wangykev/Splitflap/Kevin Splitflap/[Build18 2027] Team #138 - Parts List.xlsx

Part Name | Quantity | Unit Cost | Total Cost | Link | Who will purchase? (Build18/Ourselves) | Replacement Option Quantity | Replacement Option Unit Cost | Replacement Option Link
1. Module hardware (45 split-flap modules)
M3 hex nut, 304 stainless, 300-pc pack (need 540) | 2 | $6.88 |  | https://www.amazon.com/dp/B0DM1JHK1D | Build18
M3 x 8 mm countersunk flat-head screw, KADRICK, 300-pc pack (need 180) | 1 | $8.99 |  | https://www.amazon.com/dp/B0H1CKZ7PS | Build18
M3 x 30 mm countersunk flat-head screw, KADRICK, 200-pc pack (need 180) | 1 | $7.99 |  | https://www.amazon.com/dp/B0H1CMJY7Q | Build18
M3 x 40 mm countersunk flat-head screw, KADRICK, 170-pc pack (need 190) | 2 | $7.99 |  | https://www.amazon.com/dp/B0H1CTDXTB | Build18
A3144 Hall-effect sensor, 30-pc pack (need 45) | 2 | $6.88 |  | https://www.amazon.com/dp/B0DQ4GV916 | Build18
28BYJ-48 stepper motor, 12 V version (NOT 5 V), 5-wire with JST-XH plug, 6 motors + 6 ULN2003 boards per pack (need 45 + 3 spares). Select the 12 V option | 8 | $14.49 |  | https://www.amazon.com/dp/B0CZNGF43R | Build18 | 24 | $8.49 | https://www.amazon.com/dp/B0GQYKFGS3 (DIYables, 2 sets per pack, 12V option)
Pogo pin, 2.0 mm gold, 9 mm (5.0 mm tube, 1.0 mm tail), 100-pc pack (need 184) | 2 | $12.99 |  | https://www.amazon.com/dp/B07FPKKK9W | Build18
Neodymium magnet, N52, 3 mm dia x 1 mm, 1000-pc pack (need 45) | 1 | $21.59 |  | https://www.amazon.com/dp/B0F4CD3GC1 | Build18
JST-PH 2.0 mm 3-pin pigtail cable, 15 cm, 60 pairs (Hall sensor, need 45). Must be JST-PH 2.0 mm, NOT JST-XH; choose the "2.0mm 3Pin-15cm" option | 1 | $12.79 |  | https://www.amazon.com/dp/B0F6SZWBQR | Build18 | 2 | $8.29 | https://www.amazon.com/dp/B0DF2JQXWN (30 sets JST-PH 3-pin, 15 cm)
35 mm DIN rail, slotted steel, 1 m | 3 | $7.95 |  | https://www.amazon.com/dp/B019Q9E86W | Build18
2. Programming (UPDI flasher)
CH340 USB-to-TTL serial adapter, HiLetgo, 5-pc pack | 1 | $9.79 |  | https://www.amazon.com/dp/B00LZV1G6K | Build18
1N5817 Schottky diode, BOJACK, 125-pc pack | 1 | $5.99 |  | https://www.amazon.com/dp/B07Q5H1SLY | Build18
Dupont F-M jumper wires, 20 cm, 40 pcs (already own) | 1 | $0.00 |  | https://www.amazon.com/dp/B0BRTHR2RL | Ourselves
3. Gateway & RS-485 bus
Waveshare ESP32-S3-RS485-CAN industrial control board (RS485 + CAN) | 1 | $26.87 |  | https://www.amazon.com/dp/B0FNCWZ3D1 | Build18
Resistor kit, 1/4 W (120 ohm bus termination; the 330 ohm LED data resistor is on the power board) (already own) | 1 | $0.00 |  | https://www.sparkfun.com/resistor-kit-1-4w-500-total.html | Ourselves
Cat-6 cable, 10 ft, twisted pair for RS-485 A/B between rows (already own) | 1 | $0.00 |  | https://vetco.net/products/cat-6_ethernet_cable_10_ft | Ourselves
4. Power
Mean Well OWA-200U-12 power brick, 12 V 15 A 180 W, 4-pin DIN output, US cord | 1 | $61.80 |  | https://www.jameco.com/z/OWA-200U-12-MEAN-WELL-12V-15A-180W-Moisture-proof-Power-Adaptor-DIN4_2324383.html | Build18 | 1 | $61.80 | https://www.bravoelectro.com/owa-200u-12.html
Kycon KPJX-4S-S female 4-pin power DIN jack, right angle, PCB mount | 1 | $1.88 |  | https://www.digikey.com/en/products/detail/kycon-inc/KPJX-4S-S/9990088 | Build18
Main power switch: Switch Components RF2-1A-DC-2-RL mini rocker, SPST off-on, 16 A @ 12 V DC, red LED dot (lights when on), 3 x 0.187" quick-connect tabs, snap-in. Panel cutout 19.2 x 13.0 mm, panel 0.75-3.0 mm thick | 1 | $3.43 |  | https://www.digikey.com/en/products/detail/switch-components/RF2-1A-DC-2-RL/11492834 | Build18 | 1 |  | https://www.jameco.com/z/RF1-1A-DC-2-B-2-Switch-Components-Mini-Rocker-2P-SPST-OFF-ON-with-ON-OFF-Print_2847895.html (Switch Components RF1-1A-DC-2-B-2: same 16 A @ 12 V DC, no LED, ON-OFF printed on the rocker; check price on Jameco)
18 AWG red/black power wire, ~15 ft (already own) | 1 | $0.00 |  | https://vetco.net/products/jsc-2440_18_awg_2_conductor_red-black_speaker_wire_-_power_wire_-usa_made | Ourselves
Heat-shrink tubing assortment (already own) | 1 | $0.00 |  |  | Ourselves
5. LED perimeter strip
BTF-LIGHTING WS2815 12 V addressable LED strip, 144 LED/m, IP30, 1 m reel (need 3 m). Select the 144 LED / 3.2 ft option | 3 | $18.89 |  | https://www.amazon.com/dp/B07LG5JG3Z | Ourselves | 1 | $36.98 | https://www.superlightingled.com/dc12v-ws2815-upgraded-ws2812b-1m-144-leds-individually-addressable-digital-led-strip-lights-dual-signal-wires-waterproof-drea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 (SuperLightingLED WS2815 144/m, IP20, one 3 m reel: choose the 3 m option)
1000 uF 25 V electrolytic capacitor: one on the power board (C1, hand-soldered), one at the LED strip input (already own) | 2 | $0.00 |  | https://vetco.net/products/1000uf25vdc_1000uf_25_volt_electrolytic_capacitor | Ourselves
6. Raspberry Pi + voice satellite
Raspberry Pi 5, 4 GB | 1 | $130.00 |  | https://www.adafruit.com/product/5812 | Ourselves
Official Raspberry Pi 27 W USB-C power supply | 1 | $14.04 |  | https://www.adafruit.com/product/5814 | Ourselves
Official Raspberry Pi 5 Active Cooler | 1 | $13.50 |  | https://www.adafruit.com/product/5815 | Ourselves
Seeed reSpeaker XVF3800 USB 4-mic array, Bare Board (USB version, NOT the XIAO version) | 1 | $69.90 |  | https://www.amazon.com/dp/B0FKGFXQQ5 | Ourselves
VEML7700 ambient light sensor, I2C, STEMMA QT | 1 | $4.95 |  | https://www.adafruit.com/product/4162 | Ourselves
Raspberry Pi 5 case (3D-printing our own) | 1 | $0.00 |  | https://www.adafruit.com/product/5816 | Ourselves
microSD card, 32 GB, high endurance (already own) | 1 | $0.00 |  | https://www.pishop.us/product/sandisk-high-endurance-microsdhc-card-32gb-blank/ | Ourselves
Speaker gasket tape, foam (seals the speaker driver's rim and enclosure seams) | 1 | $5.99 |  | https://www.amazon.com/dp/B0C2KHHDXV | Ourselves
Dayton Audio ND65-4 2.5" aluminum-cone full-range speaker driver, 4 ohm, 15 W RMS (for spoken replies; goes in our own enclosure, driven by the ReSpeaker's 5 W amp) | 1 | $23.98 |  | https://www.parts-express.com/Dayton-Audio-ND65-4-2-1-2-Aluminum-Cone-Full-Range-Driver-290-204 | Build18 | 1 | $9.75 | https://octopart.com/tc6fd00-04-peerless+by+tymphany-78639440 (Peerless by Tymphany TC6FD00-04, 2" full-range, 4 ohm, cheaper but less bass)
7. Case (plywood back, laser-cut acrylic front and sides)
3/8" x 2 ft x 4 ft sanded plywood (back panel), Home Depot. Price is an estimate; check the store | 1 | $18.00 |  | https://www.homedepot.com/b/Lumber-Composites-Plywood/2-ft-x-4-ft/Sanded/N-5yc1vZbqm7Z1z1abxgZ1z1tly8 | Build18
1/8" black cast acrylic sheet, 18 x 36 in, eStreet Plastics #2025 (SKU B011251836) (front panel: 880 x 280 mm fits in 914 x 457 mm) | 1 | $21.14 |  | https://estreetplastics.com/product/1-8-x-18-x-36-black-plexiglass-acrylic-sheet-cast-2025/ | Build18 | 1 | $40.92 | https://www.homedepot.com/p/Falken-Design-24-in-x-36-in-x-1-8-in-Thick-Acrylic-Black-Opaque-Sheet-Falken-Design-ACRYLIC-BK-1-8-2436/308669314 (24 x 36 in, same sheet, if 18 x 36 is out of stock)
1/8" black LED cast acrylic sheet, 24 x 36 in (side panels: one-piece 880 mm top and bottom strips, no seam) | 1 | $59.95 |  | https://laseredbythecreek.com/products/1-8-black-led-cast-acrylic-sheets-matte-gloss-finish | Build18 | 2 | $14.95 | Same listing, 12 x 18 in size (top and bottom would each be two strips joined at the centre)
TOTAL BUILD18 COST
TOTAL OUT-OF-POCKET COST (Ourselves)
TOTAL PROJECT PARTS COST
Excludes the PCBs (driver, bus and power boards; separate JLCPCB order) and all shipping. Rows marked Ourselves are parts we already own or are 3D-printing ourselves, listed at $0.
 |  |  |  |  | SPECIAL NOTES & IMPORTANT INFORMATION - All parts will be ordered directly through Build18. Do not purchase parts independently. - Parts will be available for pickup starting on the first day of Build Week. - Reimbursements are extremely limited and require prior approval, except for PCBs. - Include any special ordering instructions, specifications, or requests in your parts list. - Contact your assigned Build18 officer with any questions.
YOU DO NOT NEED TO ORDER YOUR OWN FILAMENTS |  |  | T-Shirt Details for all members (for Demo Day)
TechSpark 3D Print Use | Quantity |  | Team Member Name | Tshirt Size
FALSE
