wangykev/Splitflap/Kevin Splitflap/PCBs/power-board/production/bom.csv

Designator | Footprint | Quantity | Value | LCSC Part #
C1 | CP_Radial_D10.0mm_P5.00mm | 1 | 1000uF 25V
C2 | 0805 | 1 | 10uF 25V | C15850
C3 | 0603 | 1 | 100nF | C14663
C4 | 0603 | 1 | 470nF | C1623
C5 | 0805 | 1 | 10uF | C15850
D1 | D_SMC | 1 | SMCJ15A | C310016
D2 | 0603 | 1 | ON | C2286
D3 | 0603 | 1 | ROW1 | C2286
D4 | 0603 | 1 | ROW2 | C2286
D5 | 0603 | 1 | ROW3 | C2286
D6 | 0603 | 1 | GW | C2286
F1, F2, F3 | 2920 | 3 | 7A | C22363536
F4 | 2920 | 1 | 3A | C39831901
H1, H2, H3, H4 | MountingHole_3.2mm_M3 | 4 | M3
J1 | Kycon_KPJX-4S-S | 1 | KPJX-4S-S
J10 | SolderWire-1.5sqmm_1x02_P7.8mm_D1.7mm_OD3.9mm | 1 | ROCKER SWITCH
J2 | SolderWire-1sqmm_1x04_P5.4mm_D1.4mm_OD2.7mm | 1 | ROW 1 (12V B A GND)
J3 | SolderWire-1sqmm_1x04_P5.4mm_D1.4mm_OD2.7mm | 1 | ROW 2 (12V B A GND)
J4 | SolderWire-1sqmm_1x04_P5.4mm_D1.4mm_OD2.7mm | 1 | ROW 3 (12V B A GND)
J5 | SolderWire-1sqmm_1x02_P5.4mm_D1.4mm_OD2.7mm | 1 | GATEWAY PWR (12V GND)
J6 | SolderWire-0.5sqmm_1x02_P4.6mm_D0.9mm_OD2.1mm | 1 | GATEWAY RS485 (A B)
J7 | SolderWire-0.5sqmm_1x02_P4.6mm_D0.9mm_OD2.1mm | 1 | GATEWAY IO
J8 | SolderWire-1sqmm_1x04_P5.4mm_D1.4mm_OD2.7mm | 1 | LED START (12V DIN BIN GND)
J9 | SolderWire-1sqmm_1x02_P5.4mm_D1.4mm_OD2.7mm | 1 | LED END (12V GND)
JP1 | SolderJumper-2_P1.3mm_Open_RoundedPad1.0x1.5mm | 1 | TERM
NT1, NT2 | CutLink_Holes_P6mm | 2 | CUT IF REVERSED
R1, R2, R3, R4, R5 | 0603 | 5 | 4.7k | C23162
R7 | 0603 | 1 | 120 | C22787
R8 | 0603 | 1 | 100k | C25803
R9 | 0603 | 1 | 330 | C23138
U1 | SOT-23-5 | 1 | 74AHCT1G125 | C7484
U2 | SOT-89-3 | 1 | 78L05 | C71136
