wangykev/Splitflap/Kevin Splitflap/PCBs/Driverv5/production/bom.csv

Designator | Footprint | Quantity | Value | LCSC Part #
C1 | CP_Elec_6.3x5.4 | 1 | 100u | C4747964
C10, C11, C7 | 0603 | 3 | 100nF | C14663
C2, C3, C6, C8 | 0603 | 4 | 470n | C1623
C4 | 0805 | 1 | 10u | C15850
C5, C9 | 0603 | 2 | 10u | C19702
D1 | 0603 | 1 | LED | C2286
D3 | D_SMA | 1 | D_Schottky | C8678
F1 | 1812 | 1 | 750mA/24V | C12557
J3 | JST_XH_B5B-XH-A_1x05_P2.50mm_Vertical | 1 | Stepper Connector | C157991
J4 | JST_PH_B3B-PH-K_1x03_P2.00mm_Vertical | 1 | Hall Effect | C131339
R2 | 0603 | 1 | 470R | C23179
R3, R4 | 0603 | 2 | 10k | C25804
U1 | VQFN-20-1EP_3x3mm_P0.4mm_EP1.7x1.7mm | 1 | ATtiny1616-MNR | C507118
U2 | SOIC-16_3.9x9.9mm_P1.27mm | 1 | ULN2003ADR | C7512
U3 | SOIC-8_3.9x4.9mm_P1.27mm | 1 | THVD1400DR | C3235232
U5 | SOT-23-5 | 1 | SPX3819M5-L-3-3 | C9055
U6 | SOT-23-5 | 1 | SPX3819M5-L-5-0 | C13417
