wangykev/Splitflap/Kevin Splitflap/CAD Files/Center drum final.3mf

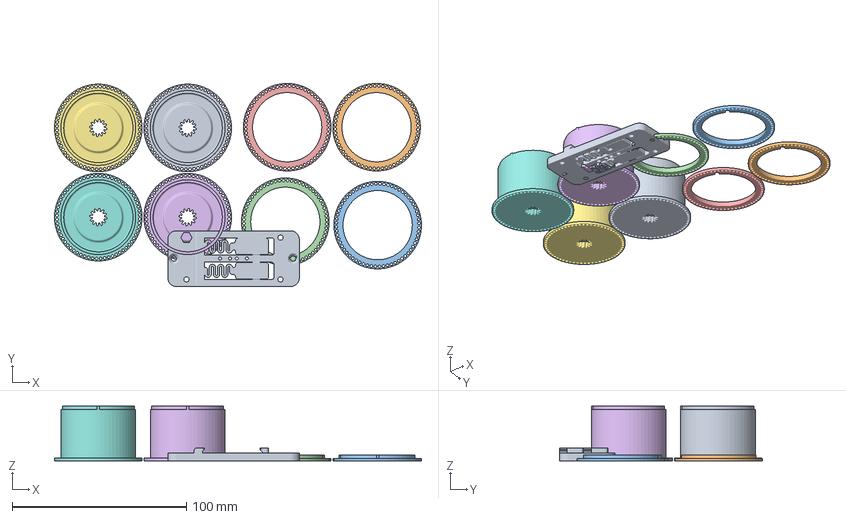
[picture p1: CAD file, 2026-11-09]
Kevin Splitflap/CAD Files/Center drum final.3mf
210.6 x 116.6 x 31.4 mm
Character Drum Main 19 18 x 4
Character Drum Lip 18 x 4
Din Bracket EasierV2.stl
