wangykev/Splitflap/Kevin Splitflap/CAD Files/DIN_Rail_Mount_final.3mf

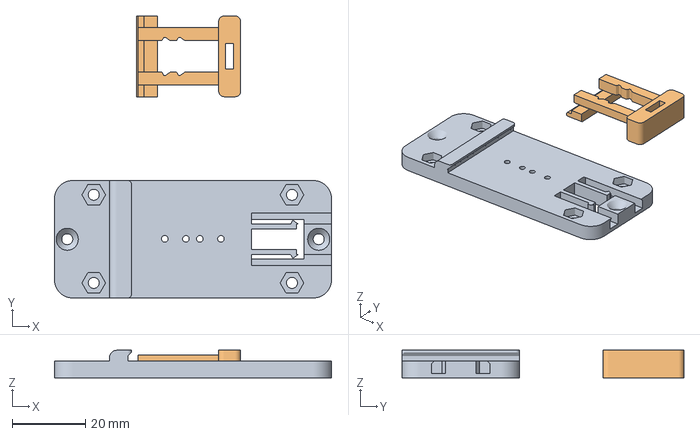
[picture p2: CAD file, 2026-11-09]
Kevin Splitflap/CAD Files/DIN_Rail_Mount_final.3mf
75.5 x 76.8 x 7.50 mm
DIN_Rail_Mount_v7.1_Grundkoerper.stl
DIN_Rail_Mount_slider.stl
