wangykev/Splitflap/Kevin Splitflap/CAD Files/Center Gear.3mf

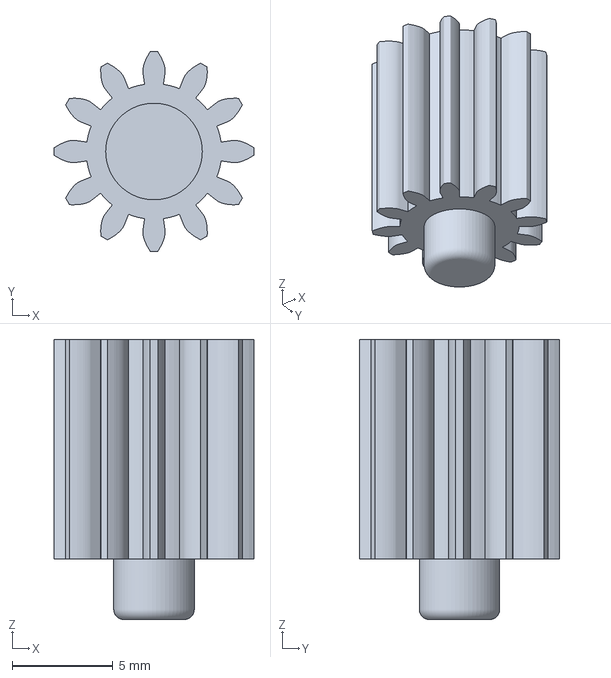
[picture p3: CAD file, 2026-11-09]
Kevin Splitflap/CAD Files/Center Gear.3mf
9.91 x 9.91 x 13.9 mm
