wangykev/Splitflap/Kevin Splitflap/CAD Files/DIN_Rail_Mount_Schieber.3mf

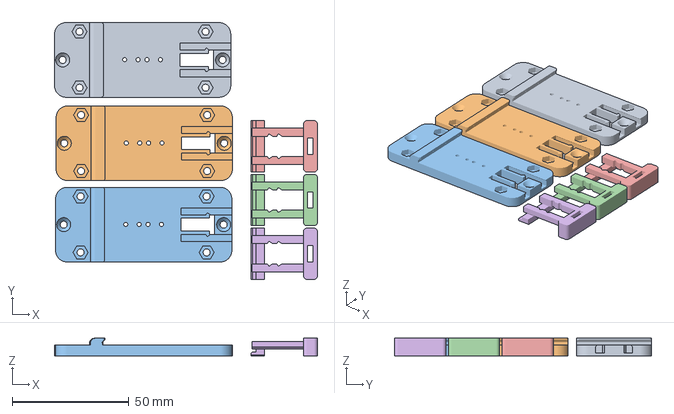
[picture p4: CAD file, 2026-11-04]
Kevin Splitflap/CAD Files/DIN_Rail_Mount_Schieber.3mf
112.6 x 110.0 x 7.50 mm
DIN_Rail_Mount_Grundkoerper.stl x 3
DIN_Rail_Mount_Schieber.stl x 3
