wangykev/Splitflap/(list of files, drawings)

Other design files:
Kevin Splitflap/PCBs/altium-old/Imported SplitFlapDriverATtiny1616V4.kicad_pcb/SplitFlapDriverATtiny1616V4.kicad_pcb(1).PcbDoc
Kevin Splitflap/PCBs/altium-old/Imported SplitFlapDriverATtiny1616V4.kicad_pcb/SplitFlapDriverATtiny1616V4.kicad_pcb.PcbDoc
Kevin Splitflap/PCBs/altium-old/Imported SplitFlapDriverATtiny1616V4.kicad_pcb/SplitFlapDriverATtiny1616V4.kicad_pcb.PrjPcb
Kevin Splitflap/PCBs/altium-old/Imported SplitFlapDriverATtiny1616V4.kicad_pcb/SplitFlapDriverATtiny1616V4.kicad_pcb.SchDoc
Kevin Splitflap/PCBs/altium-old/Imported SplitFlapDriverATtiny1616V4.kicad_pcb/SplitFlapDriverATtiny1616V4.kicad_pcb.SchLib
Kevin Splitflap/PCBs/altium-old/Splitflap.PrjPcb
