wangykev/Splitflap/Kevin Splitflap/PCBs/Driverv5/SplitFlapDriverV5.kicad_pcb.kicad_pcb

## KiCad design Kevin Splitflap/PCBs/Driverv5/SplitFlapDriverV5.kicad_pcb.kicad_pcb (2026-11-10)

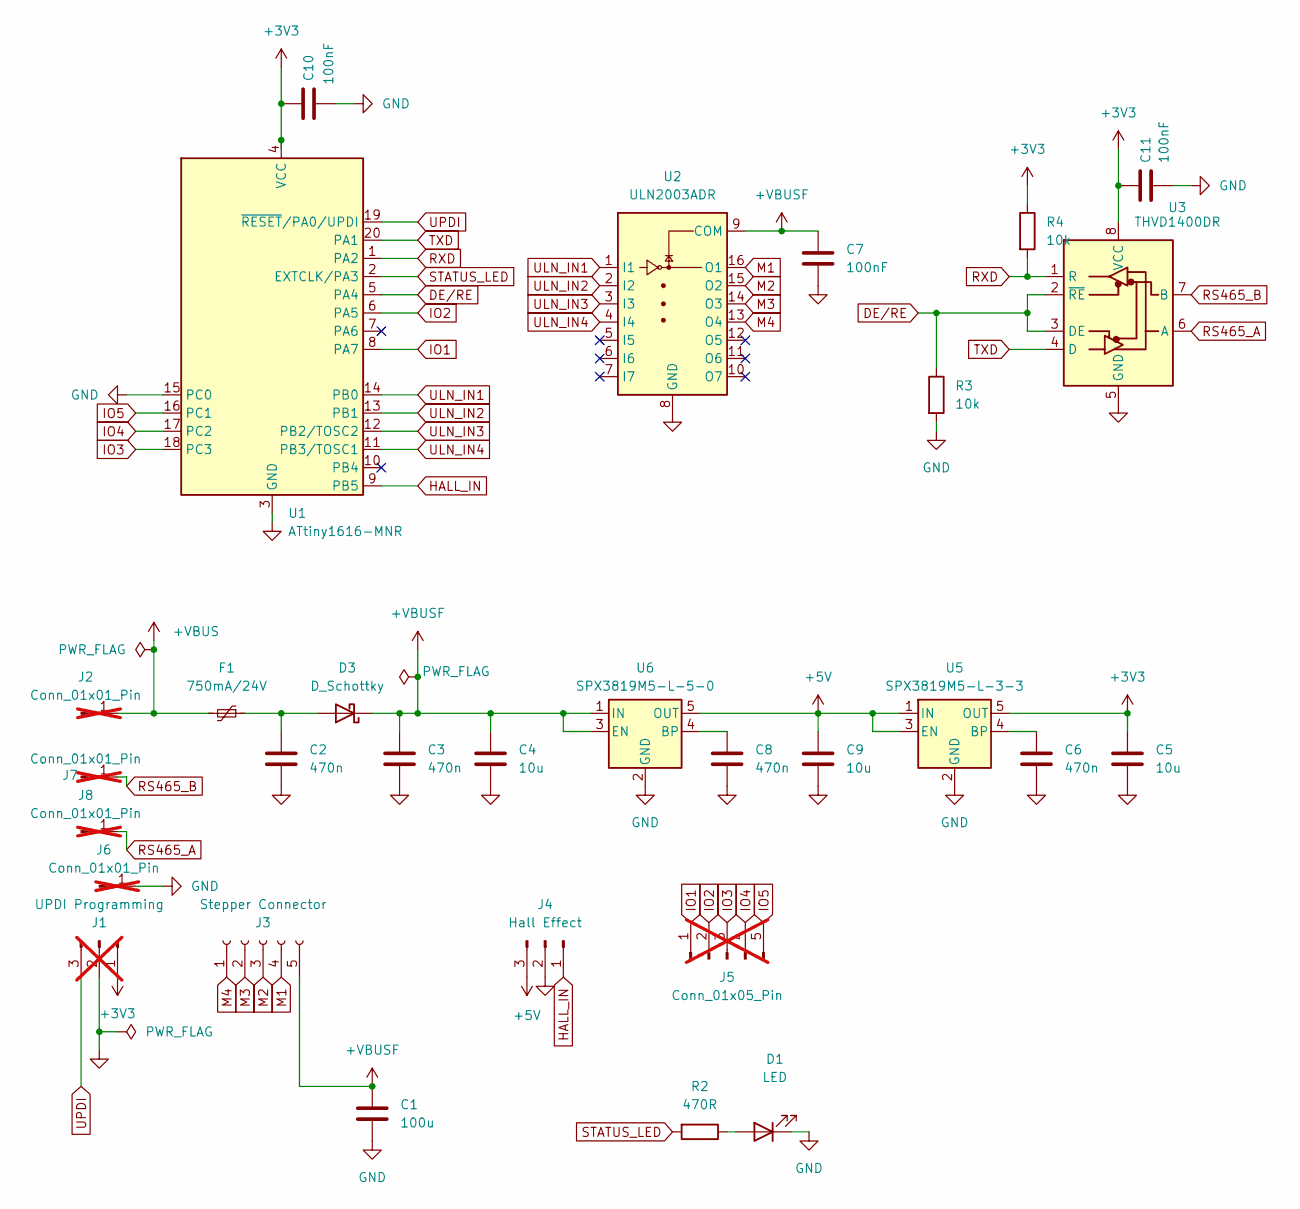
[picture p5: schematic SplitFlapDriverV5.kicad_pcb.kicad_sch]

Parts:
C1: 100u; CP_Elec_6.3x5.4; JLCPCB Part Number C4747964
C2, C3, C6, C8: 470n; C_0603_1608Metric; JLCPCB Part Number C1623
C4: 10u; C_0805_2012Metric; JLCPCB Part Number C15850
C5, C9: 10u; C_0603_1608Metric; JLCPCB Part Number C19702
C7, C10, C11: 100nF; C_0603_1608Metric; JLCPCB Part Number C14663
D1: LED; LED_0603_1608Metric; JLCPCB Part Number C2286
D3: D_Schottky; D_SMA; JLCPCB Part Number C8678
F1: 750mA/24V; Fuse_1812_4532Metric; JLCPCB Part Number C12557
J1: UPDI Programming; PinHeader_1x03_P2.54mm_Vertical; not fitted
J2, J6, J7, J8: Conn_01x01_Pin; PinHeader_1x01_P2.54mm_Vertical; not fitted
J3: Stepper Connector; JST_XH_B5B-XH-A_1x05_P2.50mm_Vertical; JLCPCB Part Number C157991
J4: Hall Effect; JST_PH_B3B-PH-K_1x03_P2.00mm_Vertical; JLCPCB Part Number C131339
J5: Conn_01x05_Pin; PinHeader_1x05_P2.54mm_Vertical; not fitted
R2: 470R; R_0603_1608Metric; JLCPCB Part Number C23179
R3, R4: 10k; R_0603_1608Metric; JLCPCB Part Number C25804
U1: ATtiny1616-MNR; VQFN-20-1EP_3x3mm_P0.4mm_EP1.7x1.7mm; Manufacturer Part Number ATTINY1616-MNR; JLCPCB Part Number C507118
U2: ULN2003ADR; SOIC-16_3.9x9.9mm_P1.27mm; Manufacturer Part Number ULN2003ADR; JLCPCB Part Number C7512
U3: THVD1400DR; SOIC-8_3.9x4.9mm_P1.27mm; Manufacturer Part Number THVD1400DR; JLCPCB Part Number C3235232
U5: SPX3819M5-L-3-3; SOT-23-5; JLCPCB Part Number C9055
U6: SPX3819M5-L-5-0; SOT-23-5; JLCPCB Part Number C13417

Connections:
+3V3: C5.1, C10.1, C11.1, J1.1, R4.1, U1.4 (VCC), U3.8 (VCC), U5.5 (OUT)
+5V: C9.1, J4.3, U5.1 (IN), U5.3 (EN), U6.5 (OUT)
+VBUS: F1.2, J2.1 (Pin_1_1)
+VBUSF: C1.1, C3.1, C4.1, C7.1, D3.1 (K), J3.5, U2.9 (COM), U6.1 (IN), U6.3 (EN)
DE/RE: R3.1, U1.5 (PA4), U3.2 (~RE), U3.3 (DE)
GND: C1.2, C2.2, C3.2, C4.2, C5.2, C6.2, C7.2, C8.2, C9.2, C10.2, C11.2, D1.1 (K), J1.2, J4.2, J6.1 (Pin_1_1), R3.2, U1.3 (GND), U1.15 (PC0), U2.8 (GND), U3.5 (GND), U5.2 (GND), U6.2 (GND)
HALL_IN: J4.1, U1.9 (PB5)
IO1: J5.1, U1.8 (PA7)
IO2: J5.2, U1.6 (PA5)
IO3: J5.3, U1.18 (PC3)
IO4: J5.4, U1.17 (PC2)
IO5: J5.5, U1.16 (PC1)
M1: J3.4, U2.16 (O1)
M2: J3.3, U2.15 (O2)
M3: J3.2, U2.14 (O3)
M4: J3.1, U2.13 (O4)
unnamed: D1.2 (A), R2.1
unnamed: C2.1, D3.2 (A), F1.1
unnamed: C6.1, U5.4 (BP)
unnamed: C8.1, U6.4 (BP)
RS465_A: J8.1 (Pin_1_1), U3.6 (A)
RS465_B: J7.1 (Pin_1_1), U3.7 (B)
RXD: R4.2, U1.1 (PA2), U3.1 (R)
STATUS_LED: R2.2, U1.2 (EXTCLK/PA3)
TXD: U1.20 (PA1), U3.4 (D)
ULN_IN1: U1.14 (PB0), U2.1 (I1)
ULN_IN2: U1.13 (PB1), U2.2 (I2)
ULN_IN3: U1.12 (PB2/TOSC2), U2.3 (I3)
ULN_IN4: U1.11 (PB3/TOSC1), U2.4 (I4)
UPDI: J1.3, U1.19 (~RESET/PA0/UPDI)

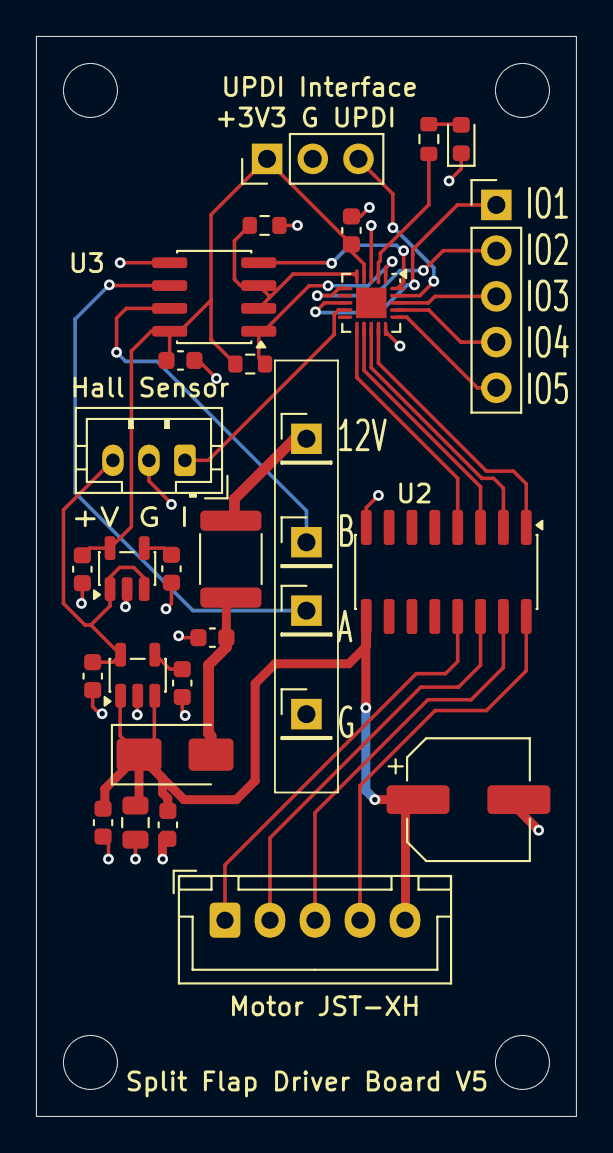
[picture p6: board SplitFlapDriverV5.kicad_pcb.kicad_pcb from above]

Board: 2 copper layers, 30.0 x 60.0 mm, 30 parts (0 on the bottom side), 30 nets.
