wangykev/Splitflap/Kevin Splitflap/PCBs/power-board/SplitFlapPowerBoard.kicad_pcb

## KiCad design Kevin Splitflap/PCBs/power-board/SplitFlapPowerBoard.kicad_pcb (2026-10-29)

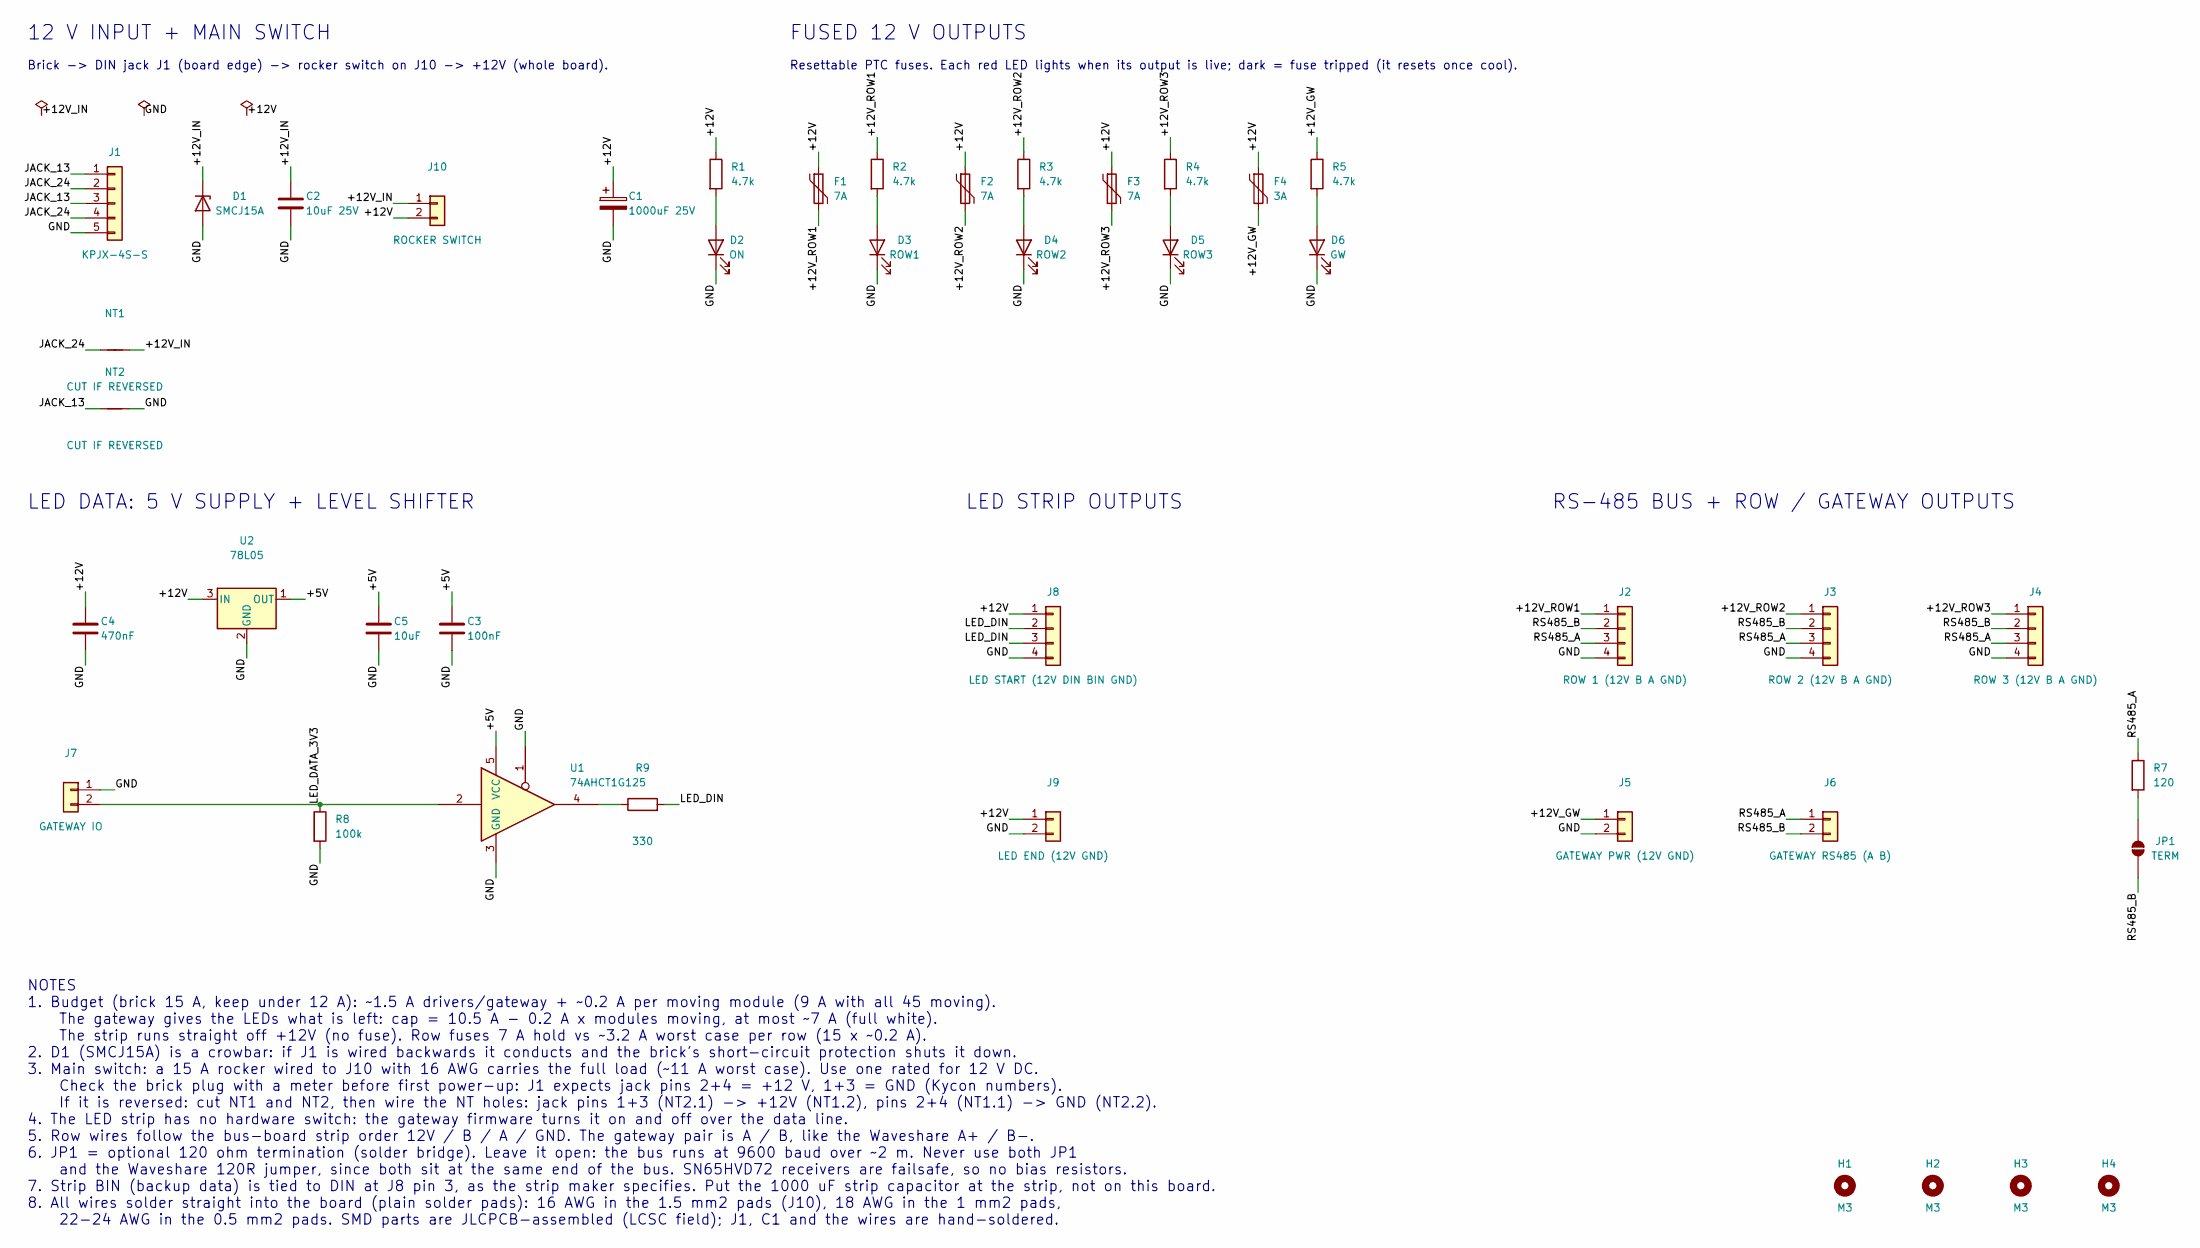
[picture p7: schematic SplitFlapPowerBoard.kicad_sch, Split-Flap Power Board]

Parts:
C1: 1000uF 25V; CP_Radial_D10.0mm_P5.00mm
C2: 10uF 25V; C_0805_2012Metric; LCSC C15850
C3: 100nF; C_0603_1608Metric; LCSC C14663
C4: 470nF; C_0603_1608Metric; LCSC C1623
C5: 10uF; C_0805_2012Metric; LCSC C15850
D1: SMCJ15A; D_SMC; LCSC C310016
D2: ON; LED_0603_1608Metric; LCSC C2286
D3: ROW1; LED_0603_1608Metric; LCSC C2286
D4: ROW2; LED_0603_1608Metric; LCSC C2286
D5: ROW3; LED_0603_1608Metric; LCSC C2286
D6: GW; LED_0603_1608Metric; LCSC C2286
F1, F2, F3: 7A; Fuse_2920_7451Metric; LCSC C22363536
F4: 3A; Fuse_2920_7451Metric; LCSC C39831901
H1, H2, H3, H4: M3; MountingHole_3.2mm_M3
J1: KPJX-4S-S; Kycon_KPJX-4S-S
J2: ROW 1 (12V B A GND); SolderWire-1sqmm_1x04_P5.4mm_D1.4mm_OD2.7mm
J3: ROW 2 (12V B A GND); SolderWire-1sqmm_1x04_P5.4mm_D1.4mm_OD2.7mm
J4: ROW 3 (12V B A GND); SolderWire-1sqmm_1x04_P5.4mm_D1.4mm_OD2.7mm
J5: GATEWAY PWR (12V GND); SolderWire-1sqmm_1x02_P5.4mm_D1.4mm_OD2.7mm
J6: GATEWAY RS485 (A B); SolderWire-0.5sqmm_1x02_P4.6mm_D0.9mm_OD2.1mm
J7: GATEWAY IO; SolderWire-0.5sqmm_1x02_P4.6mm_D0.9mm_OD2.1mm
J8: LED START (12V DIN BIN GND); SolderWire-1sqmm_1x04_P5.4mm_D1.4mm_OD2.7mm
J9: LED END (12V GND); SolderWire-1sqmm_1x02_P5.4mm_D1.4mm_OD2.7mm
J10: ROCKER SWITCH; SolderWire-1.5sqmm_1x02_P7.8mm_D1.7mm_OD3.9mm
JP1: TERM; SolderJumper-2_P1.3mm_Open_RoundedPad1.0x1.5mm
NT1, NT2: CUT IF REVERSED; CutLink_Holes_P6mm
R1, R2, R3, R4, R5: 4.7k; R_0603_1608Metric; LCSC C23162
R7: 120; R_0603_1608Metric; LCSC C22787
R8: 100k; R_0603_1608Metric; LCSC C25803
R9: 330; R_0603_1608Metric; LCSC C23138
U1: 74AHCT1G125; SOT-23-5; LCSC C7484
U2: 78L05; SOT-89-3; LCSC C71136

Connections:
/+5V: C3.1, C5.1, U1.5 (VCC), U2.1 (OUT)
/+12V: C1.1, C4.1, F1.1, F2.1, F3.1, F4.1, J8.1, J9.1, J10.2, R1.1, U2.3 (IN)
/+12V_GW: F4.2, J5.1, R5.1
/+12V_IN: C2.1, D1.1 (K), J10.1, NT1.2
/+12V_ROW1: F1.2, J2.1, R2.1
/+12V_ROW2: F2.2, J3.1, R3.1
/+12V_ROW3: F3.2, J4.1, R4.1
/GND: C1.2, C2.2, C3.2, C4.2, C5.2, D1.2 (A), D2.1 (K), D3.1 (K), D4.1 (K), D5.1 (K), D6.1 (K), J1.5, J2.4, J3.4, J4.4, J5.2, J7.1, J8.4, J9.2, NT2.2, R8.2, U1.1, U1.3 (GND), U2.2 (GND)
/JACK_13: J1.1, J1.3, NT2.1
/JACK_24: J1.2, J1.4, NT1.1
/LED_DATA_3V3: J7.2, R8.1, U1.2
/LED_DIN: J8.2, J8.3, R9.2
/RS485_A: J2.3, J3.3, J4.3, J6.1, R7.1
/RS485_B: J2.2, J3.2, J4.2, J6.2, JP1.1 (A)
unnamed: D2.2 (A), R1.2
unnamed: D3.2 (A), R2.2
unnamed: D4.2 (A), R3.2
unnamed: D5.2 (A), R4.2
unnamed: D6.2 (A), R5.2
unnamed: JP1.2 (B), R7.2
unnamed: R9.1, U1.4

Notes on the sheet:
12 V INPUT + MAIN SWITCH
Brick -> DIN jack J1 (board edge) -> rocker switch on J10 -> +12V (whole board).
FUSED 12 V OUTPUTS
Resettable PTC fuses. Each red LED lights when its output is live; dark = fuse tripped (it resets once cool).
LED DATA: 5 V SUPPLY + LEVEL SHIFTER
LED STRIP OUTPUTS
RS-485 BUS + ROW / GATEWAY OUTPUTS
NOTES 1. Budget (brick 15 A, keep under 12 A): ~1.5 A drivers/gateway + ~0.2 A per moving module (9 A with all 45 moving). The gateway gives the LEDs what is left: cap = 10.5 A - 0.2 A x modules moving, at most ~7 A (full white). The strip runs straight off +12V (no fuse). Row fuses 7 A hold vs ~3.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

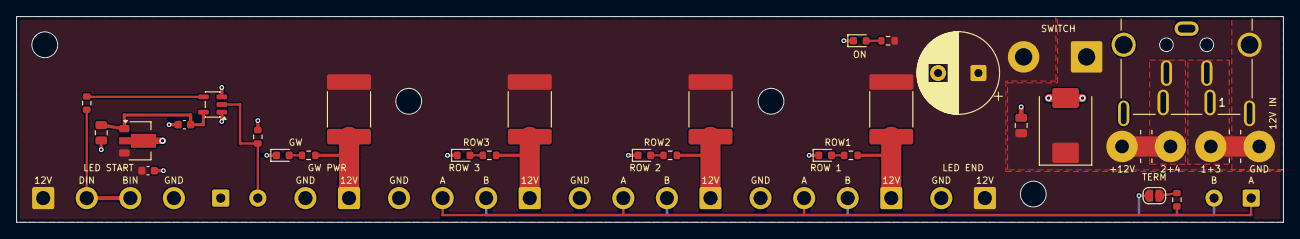
[picture p8: board SplitFlapPowerBoard.kicad_pcb from above]

Board: 2 copper layers, 157.0 x 25.5 mm, 42 parts (0 on the bottom side), 21 nets.
