wangykev/Splitflap/(commit log)

2026-10-19 Initial commit: PCBs, BOM, mock gateway, and upstream gateway submodules
2026-10-19 Update BOM with prices, links, and totals
2026-10-20 Finalize BOM: section totals, owned parts, Elecrow steppers, power and Pi side
2026-10-20 Update proposal PDF: link the full BOM
2026-10-20 Add the case (plywood back, laser-cut acrylic front and LED sides) to the BOM and proposal
2026-10-20 Use an 18 x 36 front sheet and correct the case height to 280 mm
2026-10-26 Add driver board V5 and update the BOM
    Driver board V5 replaces V4 in PCBs/Kicad:
    - RS-485 on the ATtiny1616 hardware USART (TXD PA1, RXD PA2, DE/RE PA4)
    - Narrow 3.9 mm SOIC footprints for U2 (ULN2003ADR) and U3 (SN65HVD72DR)
    - Polyfuse F1 and reverse-polarity Schottky D3 on the 12 V input
    - R3 DE/RE pull-down, R4 RXD pull-up, C10/C11 decoupling
    - JLCPCB part numbers on every placed part; headers and pogo pads DNP
    - JLCPCB production files (Gerbers, BOM, CPL)
    BOM.md: V5 parts table and the actual JLCPCB checkout total
    ($327.23 for 50 boards incl. customs and shipping), with updated totals.
    Also adds the proposal .docx source.
2026-10-26 Stop tracking KiCad Fabrication Toolkit backup zips
2026-10-27 Add bus boards, ground PC0 on driver V5, update BOM totals
    - Move the driver V5 KiCad project from PCBs/Kicad to PCBs/Driverv5 and
    tie PC0 to GND as a board ID; production files regenerated.
    - Add PCBs/bus-board-5-module: Adam G's 202 mm 5-module bus board rebuilt
    in KiCad with the A/B labels corrected to match the driver board.
    - Add PCBs/bus-board: single-piece 606 mm bus board for a 15-module row
    (not ordered).
    - BOM: bus boards ordered with the driver boards (JLCPCB checkout $348.75
    for both); wall total now ~$774.53, grand total ~$993.
    - Add Driverv5.zip snapshot.
2026-10-27 BOM: switch to external Mean Well OWA-200U-12 brick, mark JLCPCB order as quote
2026-10-28 Add power board, update BOM load budget and Pi lux sensor
    Power board (157 x 25.5 mm, 2-layer): Kycon KPJX-4S-S DIN jack input,
    rocker switch pads, SMCJ15A crowbar, 7 A PTC fuses per row, 3 A gateway
    fuse with indicator LEDs, WS2815 level shifter (74AHCT1G125 + 78L05),
    RS-485 distribution with optional 120R termination jumper. Plain solder
    pads for all wiring. ERC/DRC clean; JLC gerbers, BOM and CPL in FAB/.
    BOM: LED current cap tied to modules moving, VEML7700 lux sensor for the Pi.
2026-10-28 Driver V5: swap U3 to THVD1400DR, update BOM costs
    THVD1400DR (C3235232) is a drop-in for the SN65HVD72DR in the same
    SOIC-8 pinout: 3-5.5 V, 500 kbps, failsafe, 1/8 unit load, +/-16 V bus
    fault protection, at about a quarter of the price. No layout or firmware
    change. BOM totals adjusted by ~$68 pending a JLC re-quote.
2026-10-29 Power board: jack/switch to the right end, fix DIN jack pinout and position, add rework links
    - Mirror the layout left-right: KPJX-4S-S jack and rocker pads at the top-right
    (bottom-left when turned over), wire pads along the bottom edge.
    - Jack pinout per Mean Well's R7B plug-face drawing: Kycon pins 2+4 = +12 V,
    1+3 = GND (same side, not diagonal; Mean Well numbers its plug differently).
    - Move the jack 4 mm toward the edge so the body face sits on the board edge
    and the 4 mm barrel passes through the panel; fix the footprint outline.
    - Jack pin pairs get their own copper, joined to +12V_IN / GND by cuttable
    net-tie links (NT1, NT2) between 16 AWG solder holes, so a reversed plug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
2026-10-29 BOM: use the combined JLCPCB quote ($369.57 incl. shipping and tariffs) for drivers, bus boards and power board
2026-10-29 Driver V5: regenerate fabrication outputs after the THVD1400DR swap
2026-10-29 BOM: power section uses the PCB-mount KPJX-4S-S jack and a 20 A DC rocker switch, drops WAGO, describes power-board protection
2026-11-04 added all cad files
2026-11-09 Track gateway, module firmware and Companion directly in the repo instead of as submodules
2026-11-09 CAD: update center gear, add final center drum and DIN rail mount
2026-11-10 Driver V5: route the F1-C2-D3 power track fully into the C2 and D3 pads, regenerate Gerbers
2026-11-10 BOM: side panels from one 24 x 36 in LED acrylic sheet so the top and bottom strips are one piece
2026-11-12 BOM: level shifter is on the power board; DC-rated RF2 main switch; add Build18 parts list
    - LED strip: drop the SN74AHCT125N, buck converter, perfboard and separate 330 ohm
    resistor. The power board already has U1 (74AHCT1G125), U2 (78L05) and R9.
    Two 1000 uF caps: C1 on the power board and one at the strip input.
    - Main switch: Switch Components RF2-1A-DC-2-RL (16 A @ 12 V DC, red LED dot),
    LED ground to NT2's GND hole. RF1-1A-DC-2-B-2 (ON-OFF print) as the alternative.
    - Add the Build18 parts list spreadsheet with the same changes; the Pi 5 and
    Active Cooler are bought by us.
2026-11-12 BOM: buy the RF2-1A-DC-2-RL main switch from DigiKey instead of TME
2026-11-12 BOM: RF2-1A-DC-2-RL is $3.43 at DigiKey
2026-11-12 BOM: 3/8 in plywood back; buy a 4 ohm 5 W speaker for the ReSpeaker
2026-11-12 BOM: Dayton ND65-4 full-range speaker for natural-sounding replies
2026-11-12 Parts list: 18 x 36 in front acrylic sheet, matching the BOM
2026-11-12 BOM: sync with parts list (gasket tape, no STEMMA cable, who pays for the Pi side)
2026-11-12 BOM: front acrylic from eStreet Plastics (Falken 18 x 36 out of stock)
2026-11-12 BOM + parts list: eStreet front acrylic, LED strip bought by us, mark what we still need to buy
2026-11-12 LED strip: BTF-LIGHTING 3 x 1 m as the main pick, SuperLightingLED 3 m reel as backup
2026-11-12 Arduino Uno bench test sketch for one module (28BYJ-48 + ULN2003 + hall sensor)
2026-11-13 Module firmware: update to upstream v36 (hardware USART on the v5 driver board)
    Pulls avandeputte/SplitFlapUniversalFirmware tag 36 (8577a91), replacing the
    copy from 3264743 (v32 + docs). We had no local edits to it. The tree is
    byte-identical to upstream's (the bootloader .hex files keep upstream's CRLF).
    v33-v36 bring: bus robustness and optional checksums (v33), a real 2 s
    watchdog (v34), firmware updates over the RS-485 bus with a bootloader (v35),
    and v36's second board: on the v5 driver board the RS-485 transceiver is on
    the ATtiny1616's USART0 alternate pins (PA1 TX, PA2 RX, PA4 DE) with
    interrupt-driven receive, replacing SoftwareSerial. The board is read from a
    strap on PC0. 'pio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
2026-11-13 Gateway firmware 3.17.0 -> 4.4.0, Companion 2.10.23 -> 2.11.0 (upstream)
    Pulls avandeputte/SplitFlapGateway tag 4.4.0 (1b107d5) and
    avandeputte/SplitFlapGatewayCompanion tag v2.11.0 (latest stable; main is on
    2.12.0 betas). Neither copy had local edits (they matched upstream 1c67743 and
    ada131e exactly), and both folders are byte-identical to upstream, executable
    bits included.
    Gateway 4.x: module firmware updates over the bus (4.0), symbol flaps with
    capabilities spelling/pictographs and a new "symbols" feature (4.1), mDNS
    name "splitflap" (4.2), per-board module images for the v5 driver board (4.3),
    dashboard/MQTT/batch fixes (4.4). Display API changes are additive; features
    still has no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
2026-11-13 Mock + contract: emulate gateway 4.4.0, re-verify with Companion 2.11.0
    mock_gateway.py now reports fw 4.4.0 / api 3.3.0 and mirrors 4.4.0's
    /api/capabilities: the "symbols" feature, pictographs (symbol flaps the reel
    carries, none on the default reel) and spelling (wire byte per symbol, plus
    '"' -> 'q'). charset union/common are now in byte order like the firmware
    (3.17 already did that; the mock had used reel order). Still no "cells", so
    the Companion keeps sending /api/rs485/batch frames.
    CONTRACT.md §10 checks 1-6 re-run against the mock with the unmodified
    Companion 2.11.0: all pass. Version references updated in CONTRACT.md, the HA
    package header and CLAUDE.md (also the Phase 3 line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
2026-11-13 Bench test sketch: move the drum exactly like module firmware v36
    The Uno sketch now uses the firmware's model so its numbers carry over to the
    real module:
    - forward walks the half-step table backwards, as advance() does (the old
    sketch turned the drum the other way from the firmware)
    - a constant 1 ms per half-step, no ramp
    - the default 64-flap reel (colour flaps, q = double quote), 4096 steps/rev
    and home offset 2832
    - homing stops as soon as the sensor reads the magnet, then steps the home
    offset to flap 0; flap i is at i * stepsPerRev / flaps, rounded down
    - position re-syncs at every sensor trigger, and the stress test reports how
    far off it was
    - sensor polarity auto-detectio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
